cy2016-1/dummy/bom/README.md

# Belts caculation tools
1. https://jp.misumi-ec.com/tbtp/FA_WEB/pulley_cn/?rid=article
1. http://gaigibelt.com/competitionDetail/id/424.html
