cy2016-1/dummy/bom/all_parts_dummy_1210.xlsx

Sheet: Motor-42
Comment | Description | Designator | Footprint | LibRef | Quantity
0.1uF | Capacitor | C1, C2, C4, C5, C6, C7, C8, C9, C15, C17, C18, C21, C25, C26 | CAP_0402 | 电容-0402 | 14
10uF | Capacitor | C3, C10, C19, C22, C24 | CAP_0402 | 电容-0402 | 5
100uF | Capacitor | C11, C12, C13, C14 | 1206-CAP | 电容-1206 | 4
100pF | Capacitor | C16 | CAP_0402 | 电容-0402 | 1
10uF/50V | Capacitor | C20 | CAP_0402 | 电容-0402 | 1
10nF | Capacitor | C23 | CAP_0402 | 电容-0402 | 1
SS54 | Diode | D1 | DO-214AC | Diode_SMA | 1
SMBJ28CA |  | D2 | SMBJ-CA_MFG | SMBJ28CA | 1
二极管-5819W | 40V | D3, D4 | SOD-323 | 二极管-5819W | 2
跳线 | Resistor | J1 | 0402-0R | 跳线 | 1
TACT 2P | Button | K1, K2 | ButtonTACT_3x4x2_180 | ButtonTACT_3x4x2_180 | 2
6.8uH |  | L1 | IND-201612 | 电感-201612 | 1
SH1.0-5P |  | P1 | SH1.0-5P | SH1.0-5P | 1
SH1.0-6P |  | P2, P3, P4 | SH1.0-6P | SH1.0-6P | 3
SH1.0-3P | Header | P5 | SH1.0-3P | SH1.0-3P | 1
1K | Resistor | R1, R2, R6, R7, R17 | RES_0402 | 电阻-0402 | 5
0.1R | Resistor | R3, R8 | 1206-RES | 电阻-1206 | 2
NCP15XH103F03RC | THERMISTOR 10K OHM NTC 0402 SMD | R4 | RES_0402 | NCP15XH103F03RC | 1
3.3K | Resistor | R5 | RES_0402 | 电阻-0402 | 1
10K | Resistor | R9, R10, R13, R16 | RES_0402 | 电阻-0402 | 4
120R | Resistor | R11, R12 | RES_0402 | 电阻-0402 | 2
1.8K | Resistor | R14 | RES_0402 | 电阻-0402 | 1
1M | Resistor | R15 | RES_0402 | 电阻-0402 | 1
测试点 |  | T1, T2 | TEST_PT | 测试点 | 2
TB67H450FNG | PWM Chopper Type DC Brushed Motor Driver | U1, U2 | SO-8-PAD | TB67H450FNG | 2
STM32F103CBT6 | ARM Cortex-M3 32-bit MCU, 128 KB Flash, 20 KB Internal RAM, 37 I/Os, 48-pin LQFP, -40 to 85 degC, Tray | U3 | LQFP-48 | STM32F103CBT6 | 1
TL431IDBZT | Adjustable precision shunt regulator 3-SOT-23 -40 to 85 | U4 | SOT23-3 | TL431IDBZT | 1 | taobao
SN65HVD232D |  | U5 | SO-8 | SN65HVD232D | 1
ME3116 | DC-DC | U6 | SOT23-6 | ME3116 | 1
LP2992 3V3 | LDO | U7 | SOT23-5 | LP2992 | 1
MT6816 | Magnetic Position Sensor | U8 | SO-8 | MT6816 | 1
12MHz | 村田贴片 | Y1 | 晶振-3P | 晶振-3Pin | 1 | taobao

Sheet: Motor-20
Comment | Description | Designator | Footprint | LibRef | Quantity
0.1uF | Capacitor | C1, C2, C3, C4, C5, C6, C7, C8, C11, C15, C16, C20, C21 | CAP_0402 | 电容-0402 | 13
100uF | Capacitor | C9, C10 | 1206-CAP | 电容-1206 | 2
10uF | Capacitor | C12, C17, C18, C19 | CAP_0402 | 电容-0402 | 4
10nF | Capacitor | C13 | CAP_0402 | 电容-0402 | 1
100pF | Capacitor | C14 | CAP_0402 | 电容-0402 | 1
SS54 | Diode | D1 | DO-214AC | Diode_SMA | 1
SMBJ28CA |  | D2 | SMBJ-CA_MFG | SMBJ28CA | 1
二极管-5819W | 40V | D3, D4 | SOD-323 | 二极管-5819W | 2
跳线 | Resistor | J1 | 0402-0R | 跳线 | 1
TACT 2P | Button | K1, K2 | ButtonTACT_3x4x2_180 | ButtonTACT_3x4x2_180 | 2
6.8uH |  | L1 | IND-201612 | 电感-201612 | 1
SH1.0-2P |  | P1, P2 | SH1.0-2P | SH1.0-2P | 2
SH1.0-3P | Header | P3 | SH1.0-3P | SH1.0-3P | 1
1K | Resistor | R1, R2, R4, R5, R14 | RES_0402 | 电阻-0402 | 5
0.1R | Resistor | R3, R6 | 1206-RES | 电阻-1206 | 2
10K | Resistor | R7, R8, R10, R13 | RES_0402 | 电阻-0402 | 4
120R | Resistor | R9 | RES_0402 | 电阻-0402 | 1
1.8K | Resistor | R11 | RES_0402 | 电阻-0402 | 1
1M | Resistor | R12 | RES_0402 | 电阻-0402 | 1
TB67H450FNG | PWM Chopper Type DC Brushed Motor Driver | U1, U2 | SO-8-PAD | TB67H450FNG | 2
STM32F103CBT6 | ARM Cortex-M3 32-bit MCU, 128 KB Flash, 20 KB Internal RAM, 37 I/Os, 48-pin LQFP, -40 to 85 degC, Tray | U3 | LQFP-48 | STM32F103CBT6 | 1
SN65HVD232D |  | U4 | SO-8 | SN65HVD232D | 1
LP2992 3V3 | LDO | U5 | SOT23-5 | LP2992 | 1
ME3116 | DC-DC | U6 | SOT23-6 | ME3116 | 1
MT6816 | Magnetic Position Sensor | U7 | SO-8 | MT6816 | 1
12MHz | 村田贴片 | Y1 | 晶振-3P | 晶振-3Pin | 1 | taobao

Sheet: REF-UNIT
Comment | Description | Designator | Footprint | LibRef | Quantity
OLED-12880 |  | 1 | OLED-12880 | OLED-12880 | 1
0.1uF | Capacitor | C1, C6, C7, C9, C12, C13, C14, C15, C16, C20 | CAP_0402 | 电容-0402 | 10
10uF | Capacitor | C2, C5, C10, C11, C17, C18, C19 | CAP_0402 | 电容-0402 | 7
10nF | Capacitor | C3, C4 | CAP_0402 | 电容-0402 | 2
2.2nF | Capacitor | C8 | CAP_0402 | 电容-0402 | 1
color? | LED | D1 | LED_0402_RED | LED_0402 | 1
B2B-Connector-28P-0.5mm |  | J1, J2 | B2B-0.5mm-28P-M | B2B-Connector-28P-0.5mm | 2
2K | Resistor | R1, R2, R3 | RES_0402 | 电阻-0402 | 3
4.7K | Resistor | R4, R5, R8 | RES_0402 | 电阻-0402 | 3
10K | Resistor | R6, R13 | RES_0402 | 电阻-0402 | 2
560K | Resistor | R7 | RES_0402 | 电阻-0402 | 1
120R/NC | Resistor | R9 | RES_0402 | 电阻-0402 | 1
0R | Resistor | R10, R11 | RES_0402 | 电阻-0402 | 2
22R | Resistor | R12, R14 | RES_0402 | 电阻-0402 | 2
LP2992 3V3 | LDO | U1 | SOT23-5 | LP2992 | 1
MPU6050 | 六轴传感器 | U2 | QFN-24 | MPU6050 | 1
SN65HVD232D |  | U3 | SO-8 | SN65HVD232D | 1
STM32F405RGT6 | ARM Cortex-M4 32-bit MCU+FPU, 210 DMIPS, 1024 kB Flash, 192 kB Internal RAM, 51 I/Os, 64-pin LQFP, -40 to 85 degC, Tray | U4 | LQFP-64_N | STM32F405RGT6 | 1
8MHz | 村田贴片 | Y1 | 晶振-3P | 晶振-3Pin | 1 | taobao

Sheet: REF-Base
Comment | Description | Designator | Footprint | LibRef | Quantity
RAINSUN |  | A1 | ANT-Rainsun-AN5120 | ANT-Rainsun-AP5120 | 1
10uF | Capacitor | C1, C5, C10, C15 | CAP_0402 | 电容-0402 | 4
0.1uF | Capacitor | C2, C4, C8, C9, C12, C14 | CAP_0402 | 电容-0402 | 6
1uF | Capacitor | C3 | CAP_0402 | 电容-0402 | 1
100uF | Capacitor | C6 | 1206-CAP | 电容-1206 | 1 | 22uF/35V
10nF | Capacitor | C7, C13 | CAP_0402 | 电容-0402 | 2
100pF | Capacitor | C11 | CAP_0402 | 电容-0402 | 1
10uF/50V | Capacitor | C16 | CAP_0402 | 电容-0402 | 1 | 2.2uF/35V
color? | LED | D1 | LED_0402_RED | LED_0402 | 1
SS54 | Diode | D2 | DO-214AC | Diode_SMA | 1
SMBJ28CA |  | D3 | SMBJ-CA_MFG | SMBJ28CA | 1
二极管-5819W | 40V | D4, D5 | SOD-323 | 二极管-5819W | 2
USB-TYPE-C-STAND |  | J1 | USB-TYPE-C-STAND | USB-TYPE-C-STAND | 1
6.8uH |  | L1 | IND-201612 | 电感-201612 | 1
SH1.0-5P |  | P1 | SH1.0-5P | SH1.0-5P | 1
SH1.0-2P |  | P2, P3, P4 | SH1.0-2P | SH1.0-2P | 3
SH1.0-3P | Header | P5, P6 | SH1.0-3P | SH1.0-3P | 2
BC847BVC-7 |  | Q1 | SOT563-6 | BC847BVC-7 | 1
AO3400A | N-MOS | Q2 | SOT23-3 | AO3400A | 1
AO3401A | P-MOS | Q3 | SOT23-3 | AO3401A | 1
10K | Resistor | R1, R5, R10, R11, R15 | RES_0402 | 电阻-0402 | 5
0R | Resistor | R2 | RES_0402 | 电阻-0402 | 1
200R | Resistor | R3 | RES_0402 | 电阻-0402 | 1
12K | Resistor | R4, R6 | RES_0402 | 电阻-0402 | 2
2K | Resistor | R7, R12 | RES_0402 | 电阻-0402 | 2
5.1K | Resistor | R8, R9 | RES_0402 | 电阻-0402 | 2
1K | Resistor | R13 | RES_0402 | 电阻-0402 | 1
1.8K | Resistor | R14 | RES_0402 | 电阻-0402 | 1
1M | Resistor | R16 | RES_0402 | 电阻-0402 | 1
REF-Unit | Robot Embedded Framework based on STM43F405RGT6. | S1 | REF-UNIT | REF-Unit | 1
CP2102 | USB转TTL | U1 | QFN-28 | CP2102 | 1
ESP32_SIP |  | U2 | QFN-48_7X7 | ESP32-PICO | 1
LP2992 3V3 | LDO | U3, U6 | SOT23-5 | LP2992 | 2
DET402 |  | U4 | DET402 | DET402 | 1
SN65HVD232D |  | U5 | SO-8 | SN65HVD232D | 1
NRF24L01 |  | U7 | NRF24L01-MODULE | NRF24L01模块 | 1
ME3116 | DC-DC | U8 | SOT23-6 | ME3116 | 1
S8050 | Surface mount NPN transistor, package SOT-23 | VT1 | SMT_TRIODE_NPN | SMT_TRIODE_NPN | 1

Sheet: screws
 |  | 数量
J1
M4*21mm |  | 2
M4*12MM | mini11 减速器到base外壳 | 2
M3*34MM | 42电机 | 4
M3*5MM | mini11 减速器适配件固定到42电机 | 2
M3*20MM | j1 固定到外壳 | 6
M3*18MM | j1 连杆固定到j2减速器 | 3
固定底座
M3*28MM | 固定到底座 | 4
J2/J3
M3*25 | 固定j2/j3减速器适配件 | 4
M3*30 | 固定j2/j3减速器到连杆 | 4
M3*15 | 固定j2 42 Motor到连杆 | 4
M3*42 | 固定3个 42 Motor 驱动板 | 12
M3*11MM | 固定j3 42 Motor到连杆 | 4
Joint4
M3*6MM | 固定j4 35 Motor到连杆 | 4
M3*13MM | 固定3个 35 Motor 驱动板 | 12
M3*13Mm | 固定j4减速器到连杆 | 3
Joint5
M3*8MM | 固定2个 35 Motor 到连杆 | 4
M3*19MM | 固定j5减速器到连杆 | 1

Sheet: 3d
 |  | 数量
Base.stl | joint1底座 | 1
joint23.stl | joint23联杆 | 1
joint4.stl | joint4联杆 | 1
joint5.stl | joint5联杆 | 1
joint6.stl | joint6联杆 | 1
mini11-bracket-metal.stl | mini11与42电机连接支架 | 1
mini8-bracket-metal.stl | mini8谐波连接支架 | 4
motor42-bracket-top-metal.stl | 42驱动板散热顶盖 | 3
motor35-bracket-top-metal.stl | 35驱动板散热顶盖 | 2

Sheet: parts
42电机驱动板 |  | 3 | b站 木子晓汶 工房
35电机驱动板 |  | 3 | b站 木子晓汶 工房
42 电机 | l=40 1a | 3 | https://item.taobao.com/item.htm?id=549501040122&ns=1&abbucket=13
35 电机 | l=28 1a | 3 | https://item.taobao.com/item.htm?spm=a1z09.2.0.0.17872e8dTWSTmP&id=15168111895&_u=83jnrl7aaaff
减速器 | mini11 | 1 | taobao
减速器 | mini8 | 5 | taobao
同步轮 | 20齿内孔5mm外径18 | 8 | https://item.taobao.com/item.htm?spm=a1z09.2.0.0.19b12e8dfRIPU3&id=625483500699&_u=a3jnrl7adc93
同步皮带 | 152mm | 1 | https://item.taobao.com/item.htm?spm=a1z09.2.0.0.19b12e8dfRIPU3&id=626759355655&_u=a3jnrl7aa476
同步皮带 | 120mm | 1 | https://item.taobao.com/item.htm?spm=a1z09.2.0.0.19b12e8dfRIPU3&id=626759355655&_u=a3jnrl7aa476
同步皮带 | 110mm | 1 | https://item.taobao.com/item.htm?spm=a1z09.2.0.0.19b12e8dfRIPU3&id=626759355655&_u=a3jnrl7aa476
同步皮带 | 184mm | 1 | https://item.taobao.com/item.htm?spm=a1z09.2.0.0.19b12e8dfRIPU3&id=626759355655&_u=a3jnrl7aa476
电源开关 | 开孔直径：16mm，12-24v | 1 | https://item.taobao.com/item.htm?spm=a1z09.2.0.0.6dcd2e8dgKFAl1&id=589544046782&_u=93jnrl7aceb2
DC电源插座 | DC5.5*2.5mm | 1 | https://item.taobao.com/item.htm?spm=a1z09.2.0.0.6dcd2e8dgKFAl1&id=679108658727&_u=93jnrl7a3b6f
电源 | 24v 6a | 1 | https://item.taobao.com/item.htm?spm=a1z09.2.0.0.6dcd2e8dgKFAl1&id=552809889509&_u=93jnrl7a25cd
6pin排线 | zh1.5mm 30CM(定做) | 1 | https://detail.tmall.com/item.htm?_u=93jnrl7a54c7&id=642559605753&spm=a1z09.2.0.0.6dcd2e8dgKFAl1
6pin排线 | zh1.5mm 20CM(定做) | 6 | https://detail.tmall.com/item.htm?_u=93jnrl7a54c7&id=642559605753&spm=a1z09.2.0.0.6dcd2e8dgKFAl1
