cy2016-1/dummy/3d-model/OutStpFan/dummy_boards_bom.xlsx

Sheet: REF
Comment | Quantity | Designator | Footprint | Layer
0R | 4 | R2, R26, R27, R29 | RES_0402_1 | Top
0.1uF | 9 | C2, C8, C12, C14, C18, C19, C21, C22, C37 | CAP_0402 | Top
1K | 1 | R13 | RES_0402_1 | Top
1M | 1 | R16 | RES_0402_1 | Top
1uF | 1 | C3 | CAP_0402 | Top
1.8K | 1 | R14 | RES_0402_1 | Top
2K | 2 | R12, R18 | RES_0402_1 | Top
4.7K | 3 | R19, R20, R23 | RES_0402_1 | Top
4.7uF | 1 | C16 | C0603 | Top
5.1K | 2 | R8, R9 | RES_0402_1 | Top
6.8uH | 1 | L1 | IND-201612 | Top
10K | 6 | R1, R5, R10, R11, R15, R21 | RES_0402_1 | Top
10uF | 4 | C1, C15, C26, C27 | CAP_0402 | Top
12K | 2 | R4, R6 | RES_0402_1 | Top
100pF | 1 | C11 | CAP_0402 | Top
200R | 1 | R3 | RES_0402_1 | Top
560K | 1 | R22 | RES_0402_1 | Top
AO3400A | 1 | Q2 | SOT23-3 | Top
AO3401A | 1 | Q3 | SOT23-3 | Top
BC847BVC-7 | 1 | Q1 | SOT563-6 | Top
CP2102 | 1 | U1 | QFN-28 | Top
ESP32_SIP | 1 | U2 | QFN-48_7X7 | Top
Header 6H | 1 | P2 | CONN-TH_HC-ZH1.5-6A-s | Top
LED GREEN | 1 | LED1 | LED-0603 | Top
ME3116 | 1 | U8 | SOT23-6 | Top
MLT-7525 | 1 | U4 | BUZ-SMD_4P-L7.5-W7.5-P7.59-TL | Top
NRF24L01 | 1 | U7 | NRF24L01-MODULE | Top
OLED-12880 | 1 | 1 | OLED-12880 | Top
RAINSUN | 1 | A1 | ANT-Rainsun-AN5120 | Top
S8050 | 1 | VT1 | SMT_TRIODE_NPN | Top
SMBJ28CA | 1 | D3 | SMBJ-CA_MFG | Top
SN65HVD232D | 1 | U11 | SO-8 | Top
SS54 | 1 | D2 | DO-214AC | Top
USB-TYPE-C-STAND | 1 | J1 | USB-TYPE-C-STAND | Top
b5819W | 2 | D4, D5 | SOD-323 | Top
0R | 2 | R25, R31 | RES_0402_1 | Bottom
0.1uF | 10 | C4, C20, C23, C25, C28, C29, C30, C31, C32, C36 | CAP_0402 | Bottom
1M | 1 | R30 | RES_0402 | Bottom
2K | 2 | R7, R17 | RES_0402_1 | Bottom
2.2nF | 1 | C24 | CAP_0402 | Bottom
2.2uH | 1 | L2 | IND-252012A-2R2 | Bottom
10K | 2 | R28, R34 | RES_0402_1 | Bottom
10uF | 3 | C33, C34, C35 | CAP_0402 | Bottom
20pF | 2 | C7, C9 | CAP_0402 | Bottom
20pF | 1 | C13 | CAP_0402 | Bottom
22uF | 3 | C5, C10, C17 | C0603 | Bottom
22.1K | 1 | R35 | RES_0402_1 | Bottom
100K | 1 | R33 | RES_0402_1 | Bottom
120R/NC | 1 | R24 | RES_0402_1 | Bottom
220uF/25V | 1 | C6 | CAP-SMD_BD8.0-L8.3-W8.3-LS9.3-FD | Bottom
Header 3 | 1 | P3 | CONN-TH_HC-ZH1.5-3A-S | Bottom
Header 6H | 1 | P1 | CONN-TH_HC-ZH1.5-6A | Bottom
MPU6050 | 1 | U10 | QFN-24 | Bottom
STM32F405RGT6 | 1 | U12 | LQFP-64_N | Bottom
SY8089 2A | 1 | U3 | SOT23-5 | Bottom
XTAL-4 | 1 | Y1 | LC-SMD-3225_4P | Bottom

Sheet: Motor-42
Comment | Description | Designator | Footprint | Quantity | Layer
0.1R | Resistor | R3, R8 | 1206-RES | 2 | Bottom
10uF/50V | Capacitor, chip, ceramic | C29, C30, C31, C32, C33, C34 | 1206-CAP | 6 | Bottom
MT6816 | Magnetic Position Sensor | U8 | SO-8 | 1 | Bottom
SN65HVD232D |  | U5 | so-8 | 1 | Bottom
0 | Resistor | R21, R22 | RES_0402 | 2 | Top
0R | Resistor | R20 | 1206-RES | 1 | Top
0.1uF | Capacitor | C1, C2, C4, C5, C6, C7, C8, C9, C15, C17, C18, C21, C23, C25, C26, C27, C28, C35, C36 | CAP_0402 | 19 | Top
1K | Resistor | R1, R2, R6, R7, R11, R17, R18 | RES_0402 | 7 | Top
1M | Resistor | R15, R19 | RES_0402 | 2 | Top
1.8K | Resistor | R14 | RES_0402 | 1 | Top
3.3K | Resistor | R5 | RES_0402 | 1 | Top
6.8uH |  | L1 | IND-201612 | 1 | Top
10K | Resistor | R9, R10, R13, R16 | RES_0402 | 4 | Top
10uF | Capacitor | C3, C10, C19, C22, C24 | CAP_0402 | 5 | Top
10uF/50V | Capacitor | C20 | 1206-CAP | 1 | Top
20pF | Capacitor | C12, C13 | CAP_0402 | 2 | Top
100pF | Capacitor | C16 | CAP_0402 | 1 | Top
120R | Resistor | R12 | RES_0402 | 1 | Top
220uF/25V | Capacitor, chip, ceramic | C11, C14 | CAP-SMD_BD8.0-L8.3-W8.3-LS9.3-FD | 2 | Top
DSHP04TSGER | DIP Switches / SIP Switches 4 pos. low profile Btm Seal Tape J Bend | S1 | SW-SMD_DSHP04TS-S | 1 | Top
Header 6H | Header, 6-Pin, Right Angle | P1, P2, P3 | CONN-TH_HC-ZH1.5-6A-s | 3 | Top
LED GREEN | LED GRN SGL RA 25mA 4.1V SMD | LED1, LED2 | LED-0603 | 2 | Top
LP2992 3V3 | LDO | U7 | SOT23-5 | 1 | Top
ME3116 | DC-DC | U6 | SOT23-6 | 1 | Top
NCP15XH103F03RC | THERMISTOR 10K OHM NTC 0402 SMD | R4 | RES_0402 | 1 | Top
SMBJ28CA |  | D2 | SMBJ-CA_MFG | 1 | Top
SS54 | Diode | D1 | DO-214AC | 1 | Top
STM32F103CBT6 | ARM Cortex-M3 32-bit MCU, 128 KB Flash, 20 KB Internal RAM, 37 I/Os, 48-pin LQFP, -40 to 85 degC, Tray | U3 | LQFP-48 | 1 | Top
TACT 2P | Button | K1, K2 | ButtonTACT_3x4x2_180 | 2 | Top
TB67H450FNG | PWM Chopper Type DC Brushed Motor Driver | U1, U2 | SO-8-PAD | 2 | Top
XTAL-4 | Crystal | Y1 | LC-SMD-3225_4P | 1 | Top
二极管-5819W | 40V | D3, D4 | SOD-323 | 2 | Top

Sheet: Motor-35
Comment | Quantity | Description | Designator | Footprint | Layer
0R | 1 | Resistor | R20 | 1206-RES | Bottom
0.1R | 2 | Resistor | R3, R8 | 1206-RES | Bottom
0.1uF | 2 | Capacitor | C21, C25 | CAP_0402 | Bottom
10uF | 2 | Capacitor | C22, C24 | CAP_0402 | Bottom
10uF/50V | 4 | Capacitor, chip, ceramic | C29, C30, C31, C32 | 1206-CAP | Bottom
LP2992 3V3 | 1 | LDO | U7 | SOT23-5 | Bottom
MT6816 | 1 | Magnetic Position Sensor | U8 | SO-8 | Bottom
SN65HVD232D | 1 |  | U5 | so-8 | Bottom
SS54 | 1 | Diode | D1 | DO-214AC | Bottom
0 | 2 | Resistor | R21, R22 | RES_0402 | Top
0.1uF | 15 | Capacitor | C1, C2, C4, C5, C6, C7, C8, C9, C15, C17, C18, C23, C27, C28, C36 | CAP_0402 | Top
1K | 6 | Resistor | R1, R2, R6, R7, R11, R18 | RES_0402 | Top
1M | 2 | Resistor | R15, R19 | RES_0402 | Top
1.8K | 1 | Resistor | R14 | RES_0402 | Top
3.3K | 1 | Resistor | R5 | RES_0402 | Top
6.8uH | 1 |  | L1 | IND-201612 | Top
10K | 3 | Resistor | R9, R10, R13 | RES_0402 | Top
10uF | 3 | Capacitor | C3, C10, C19 | CAP_0402 | Top
10uF/50V | 1 | Capacitor | C20 | 1206-CAP | Top
20pF | 2 | Capacitor | C12, C13 | CAP_0402 | Top
100pF | 1 | Capacitor | C16 | CAP_0402 | Top
120R | 1 | Resistor | R12 | RES_0402 | Top
220uF/25V | 1 | Capacitor, chip, ceramic | C11 | CAP-SMD_BD8.0-L8.3-W8.3-LS9.3-FD | Top
DSHP04TSGER | 1 | DIP Switches / SIP Switches 4 pos. low profile Btm Seal Tape J Bend | S1 | SW-SMD_DSHP04TS-S | Top
Header 6H | 3 | Header, 6-Pin, Right Angle | P1, P2, P3 | CONN-TH_HC-ZH1.5-6A-s | Top
LED GREEN | 2 | LED GRN SGL RA 25mA 4.1V SMD | LED1, LED2 | LED-0603 | Top
ME3116 | 1 | DC-DC | U6 | SOT23-6 | Top
NCP15XH103F03RC | 1 | THERMISTOR 10K OHM NTC 0402 SMD | R4 | RES_0402 | Top
SMBJ28CA | 1 |  | D2 | SMBJ-CA_MFG | Top
STM32F103CBT6 | 1 | ARM Cortex-M3 32-bit MCU, 128 KB Flash, 20 KB Internal RAM, 37 I/Os, 48-pin LQFP, -40 to 85 degC, Tray | U3 | LQFP-48 | Top
TACT 2P | 2 | Button | K1, K2 | ButtonTACT_3x4x2_180 | Top
TB67H450FNG | 2 | PWM Chopper Type DC Brushed Motor Driver | U1, U2 | SO-8-PAD | Top
XTAL-4 | 1 | Crystal | Y1 | LC-SMD-3225_4P | Top
二极管-5819W | 2 | 40V | D3, D4 | SOD-323 | Top

Sheet: Screws
J1/BASE
M2*10 | 2 | fixs to controller enclosure
M3*20 | 4 | fixs to ground board
M4*20 | 2 | base to MINI11 reducer
M4*12 | 2 | MINI11 reducer bracket
M3*5 | 3 | for REF board fixs to base, flat header
M3*5 | 2 | MINI11 reducer bracket
M3*20 | 6 | MINI11 reducer adaptor to 42 Motor body
M3*20 | 3 | Joint1 link fixs to reducer
J2/J3
M3*25 | 16 | for all 4 mini8 reducer
M3*30 | 4 | for mini8 reducer fixs to arm
M3*15 | 4 | for 42 motor fixs to arm
M3*45 | 12 | for all 42 motor fixs to drive board
M3*12 | 4 | for j2/j3 up 42 motor fixs to arm
J4
M3*6 | 4 | for 35 motor fixs to arm
M3*12 | 12 | for all 35 motor fixs to drive board
J5
M3*8MM | 4 | for 35 motor fixs to arm
M3*19MM | 4 | for mini8 reducer fixs to arm
MINI8 Cover
M3*5 | 12
Bearing
5*10*4 | 5 | inner*outer*tall

Sheet: belts
J2 | 152MM
J3 | 120mm

Sheet: 机加工列表
文件名 | 工件 | 数量
base_Dummy v164 v1 | 网格板 | 1
base1_Dummy v164 v1 | 底座 | 1
base2_Dummy v164 v1 | 底座固定垫片 | 1
Joint1_Dummy v164 v1 | j1 | 1
Joint2_Joint3_Dummy v164 v1 | j2_3 | 1
Joint4_Dummy v164 v1 | j4 | 1
Joint5_Dummy v164 v1 | j5 | 1
Joint6_Dummy v164 v3 | j6 | 1
min-11-bra-connection v164 v1 | 11-30减速器支架 | 1
mini8-cover1105 v164 v1 | 8-50减速器支架 | 4
motor35-br-top v164 v1 | 35电机散热盖 | 3
motor42-br-top v164 v1 | 42电机散热盖 | 3
