cy2016-1/dummy/3d-model/OutStpFan/3D/controller_enclosure.stl

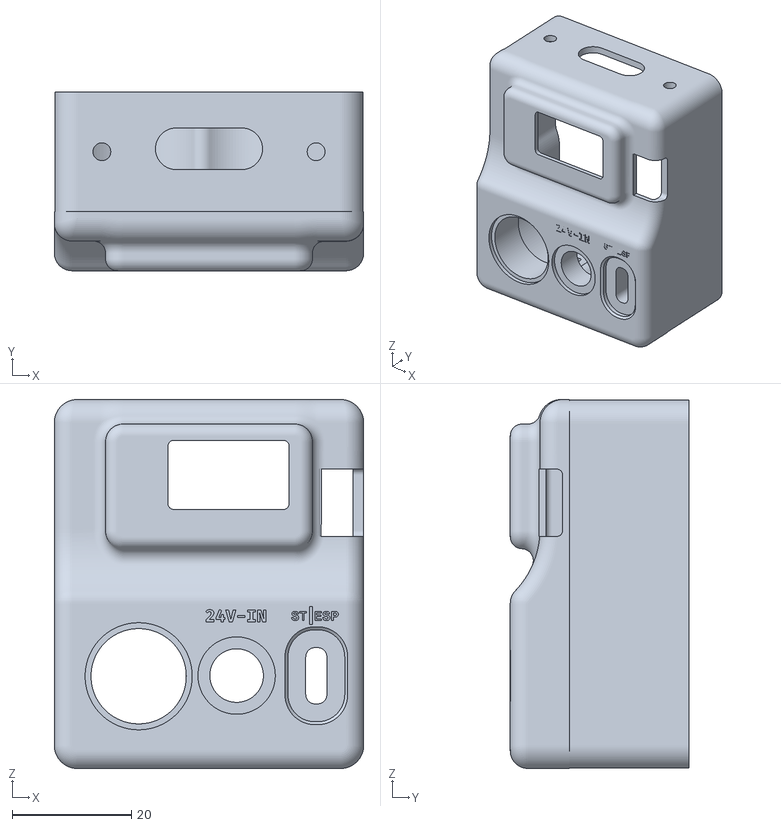
[picture p1: CAD file, 2023-12-11]
3d-model/OutStpFan/3D/controller_enclosure.stl
52.0 x 30.0 x 62.0
