cy2016-1/dummy/3d-model/OutStpFan/3D/m35/motor35-bracket-bot.stl

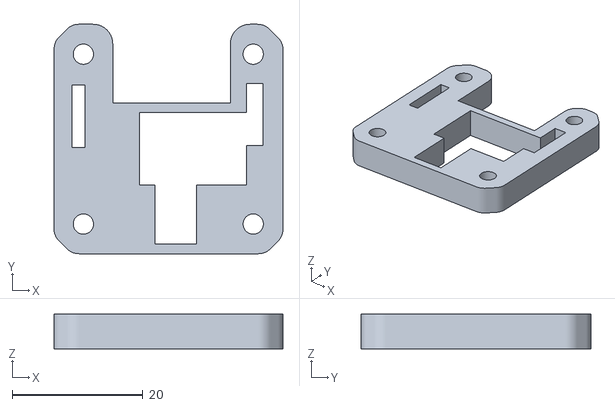
[picture p2: CAD file, 2023-12-11]
3d-model/OutStpFan/3D/m35/motor35-bracket-bot.stl
35.1 x 35.1 x 5.30
