cy2016-1/dummy/3d-model/OutStpFan/3D/m42/motor42-bracket-top-metal.stl

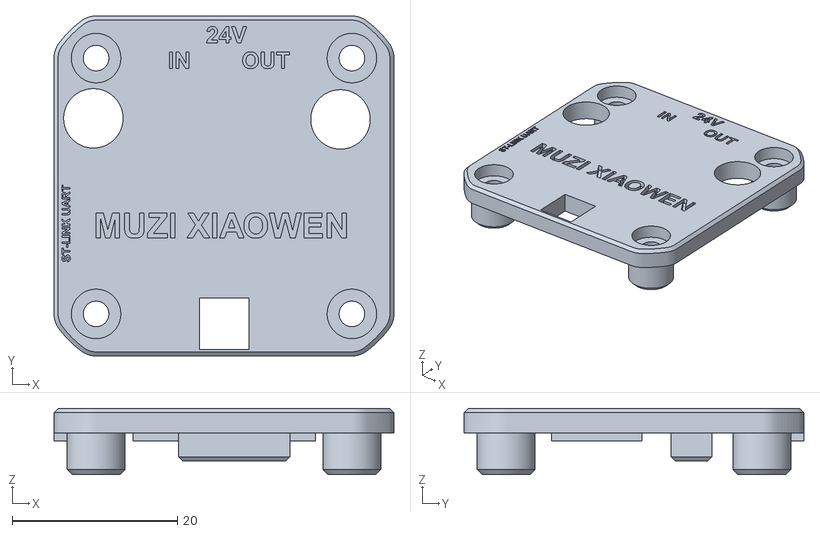
[picture p3: CAD file, 2023-12-11]
3d-model/OutStpFan/3D/m42/motor42-bracket-top-metal.stl
41.2 x 41.2 x 8.00
