cy2016-1/dummy/3d-model/OutStpFan/CNC/min-11-bra-connection v164 v1.STEP

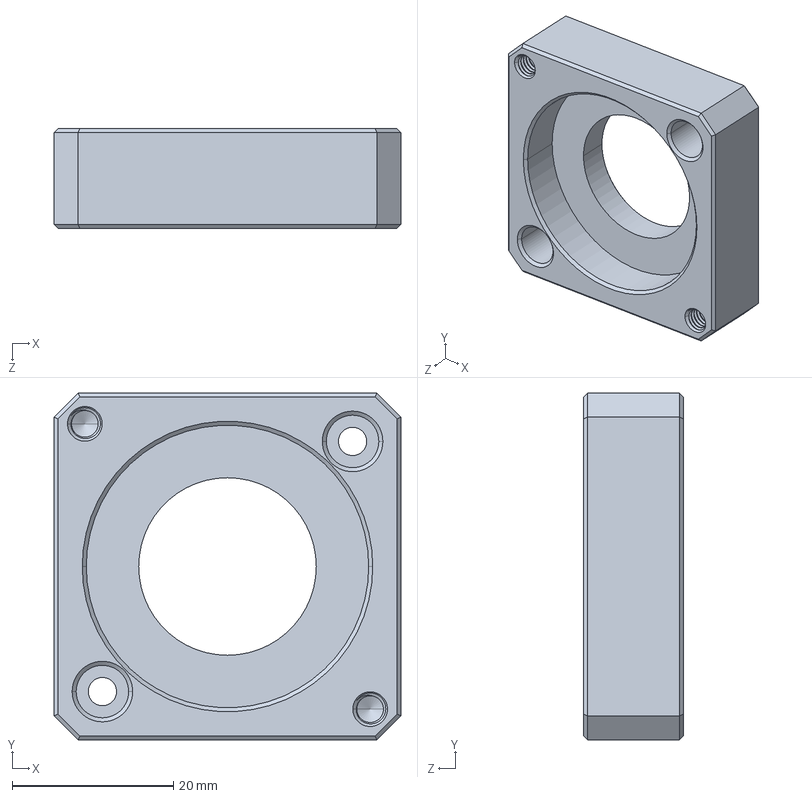
[picture p4: CAD file, 2023-12-11]
3d-model/OutStpFan/CNC/min-11-bra-connection v164 v1.STEP
43.0 x 43.0 x 12.4 mm
