cy2016-1/dummy/3d-model/OutStpFan/src/Joint5_Dummy v164 v1.SLDPRT

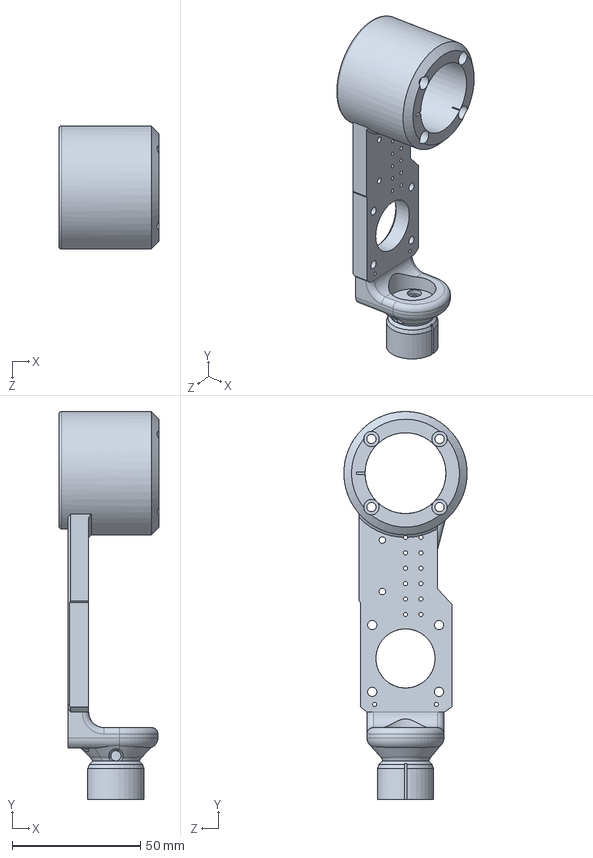
[picture p6: CAD file, 2023-12-11]
3d-model/OutStpFan/src/Joint5_Dummy v164 v1.SLDPRT
39.0 x 151.0 x 48.0 mm
