cy2016-1/dummy/3d-model/OutStpFan/3D/3DJoint5_Dummy v164 v2.STEP

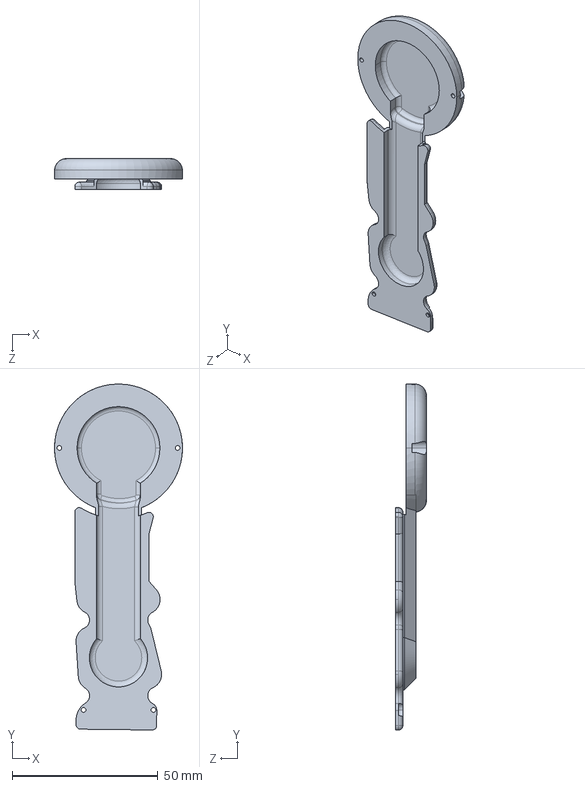
[picture p7: CAD file, 2023-12-11]
3d-model/OutStpFan/3D/3DJoint5_Dummy v164 v2.STEP
44.0 x 118.9 x 10.6 mm
