cy2016-1/dummy/3d-model/OutStpFan/3D/m35/motor35-bracket-top-metal.stl

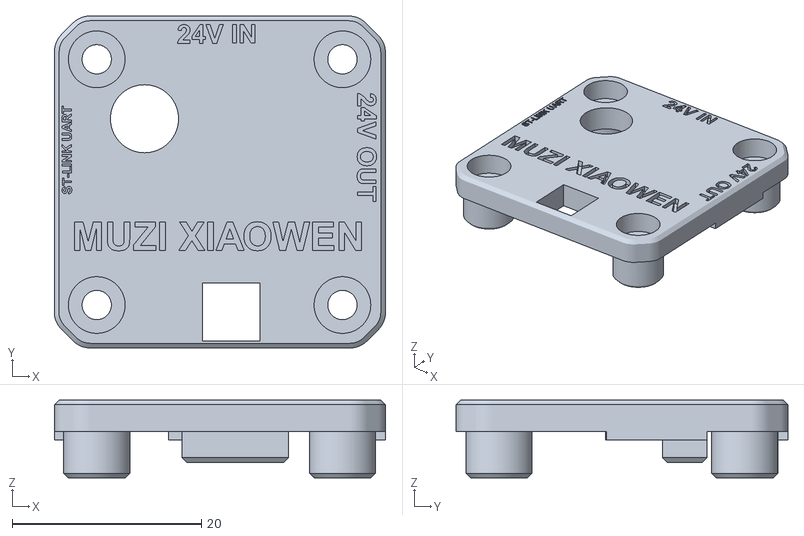
[picture p8: CAD file, 2023-12-11]
3d-model/OutStpFan/3D/m35/motor35-bracket-top-metal.stl
35.0 x 35.1 x 8.25
