cy2016-1/dummy/3d-model/OutStpFan/3D/m42/motor42-bracket-bot.stl

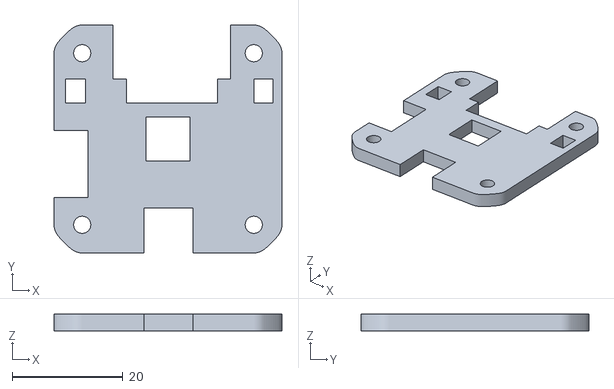
[picture p9: CAD file, 2023-12-11]
3d-model/OutStpFan/3D/m42/motor42-bracket-bot.stl
41.2 x 41.2 x 3.00
