cy2016-1/dummy/3d-model/OutStpFan/CNC/base_Dummy v164 v1.STEP

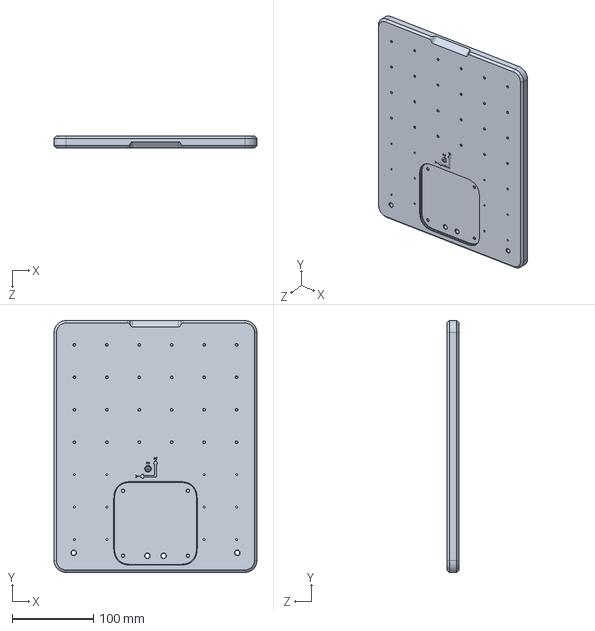
[picture p10: CAD file, 2023-12-11]
3d-model/OutStpFan/CNC/base_Dummy v164 v1.STEP
250.0 x 310.5 x 15.0 mm
