cy2016-1/dummy/3d-model/OutStpFan/src/Joint6_28Dummy v164 v4.SLDPRT

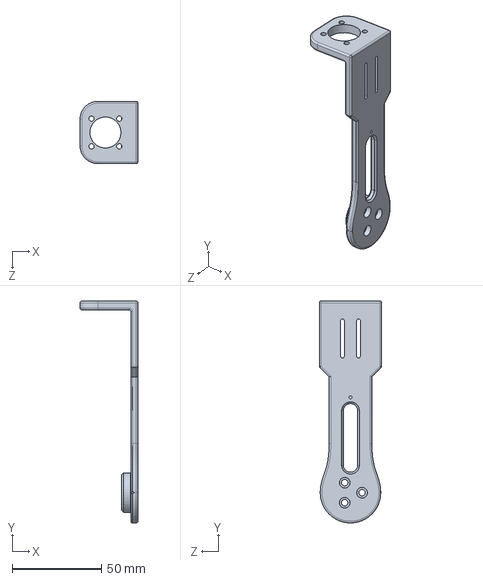
[picture p12: CAD file, 2023-12-11]
3d-model/OutStpFan/src/Joint6_28Dummy v164 v4.SLDPRT
32.5 x 124.6 x 35.0 mm
