cy2016-1/dummy/3d-model/OutStpFan/3D/3DJoint2 & Joint3_Dummy v164 v1.STEP

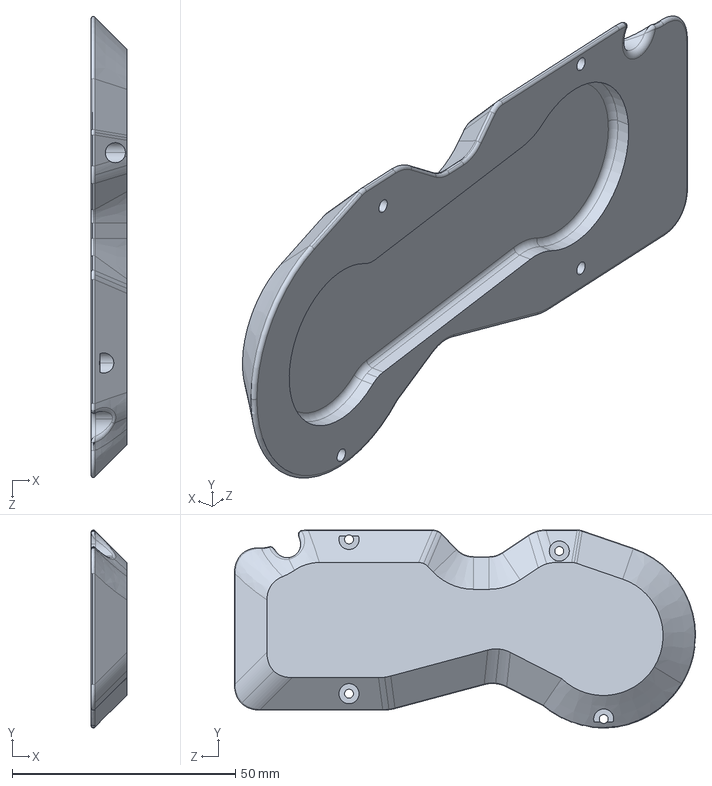
[picture p13: CAD file, 2023-12-11]
3d-model/OutStpFan/3D/3DJoint2 & Joint3_Dummy v164 v1.STEP
8.00 x 44.4 x 103.4 mm
