cy2016-1/dummy/3d-model/OutStpFan/src/Joint2 & Joint3_Dummy v164 v1.SLDPRT

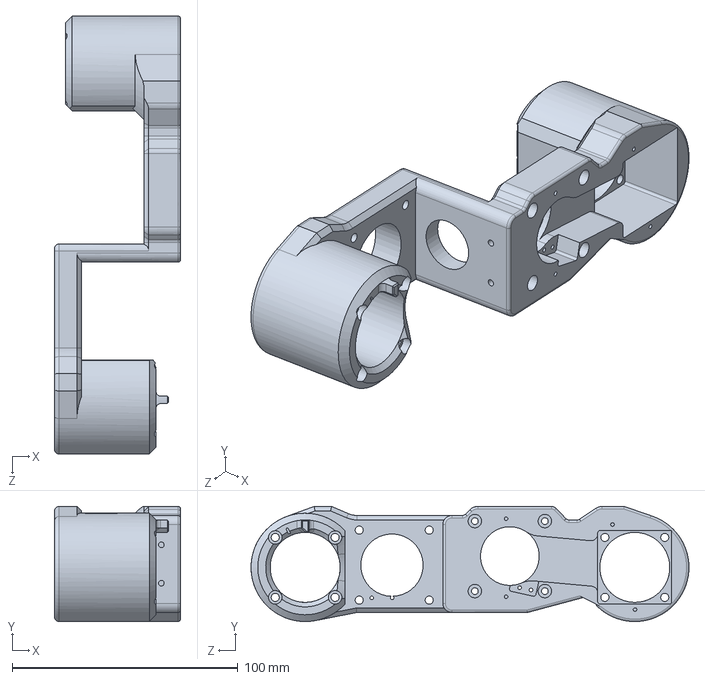
[picture p15: CAD file, 2023-12-11]
3d-model/OutStpFan/src/Joint2 & Joint3_Dummy v164 v1.SLDPRT
55.9 x 51.0 x 194.0 mm
