cy2016-1/dummy/3d-model/OutStpFan/3D/3D_1Joint2 & Joint3_Dummy v164 v1.STEP

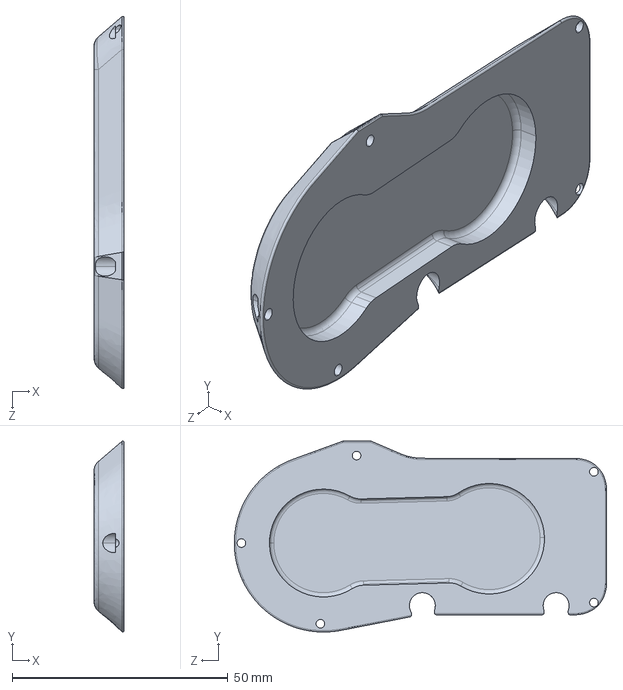
[picture p16: CAD file, 2023-12-11]
3d-model/OutStpFan/3D/3D_1Joint2 & Joint3_Dummy v164 v1.STEP
7.00 x 44.3 x 86.3 mm
