cy2016-1/dummy/3d-model/OutStpFan/CNC/base1_Dummy v164 v1.STEP

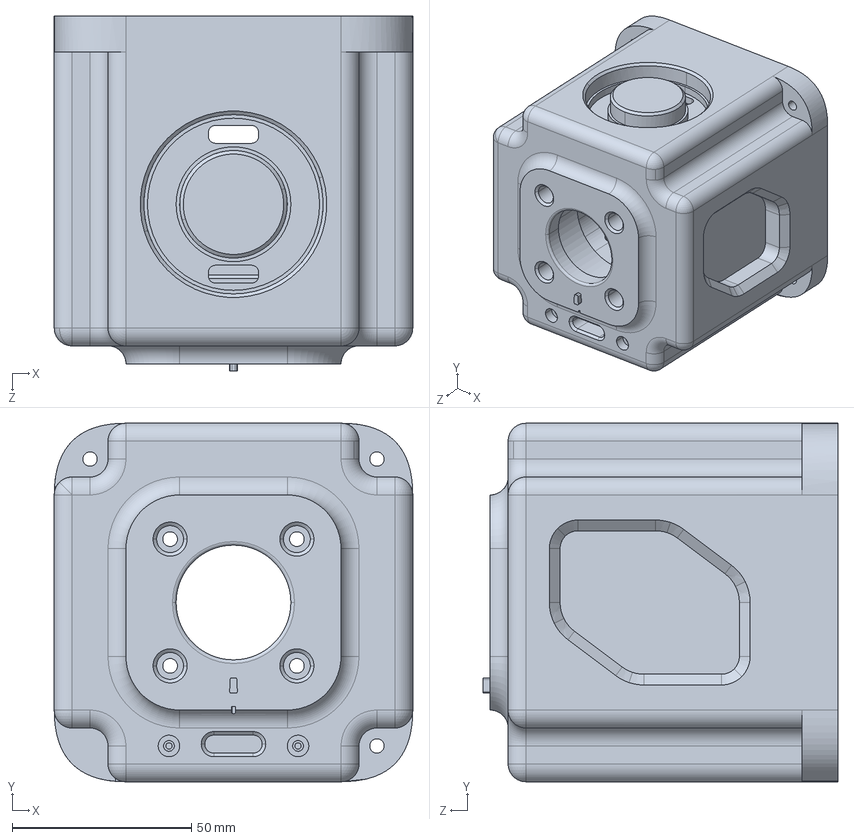
[picture p17: CAD file, 2023-12-11]
3d-model/OutStpFan/CNC/base1_Dummy v164 v1.STEP
100.0 x 100.0 x 99.0 mm
