cy2016-1/dummy/3d-model/OutStpFan/dxf/Joint4_Dummy v164 v1.DXF

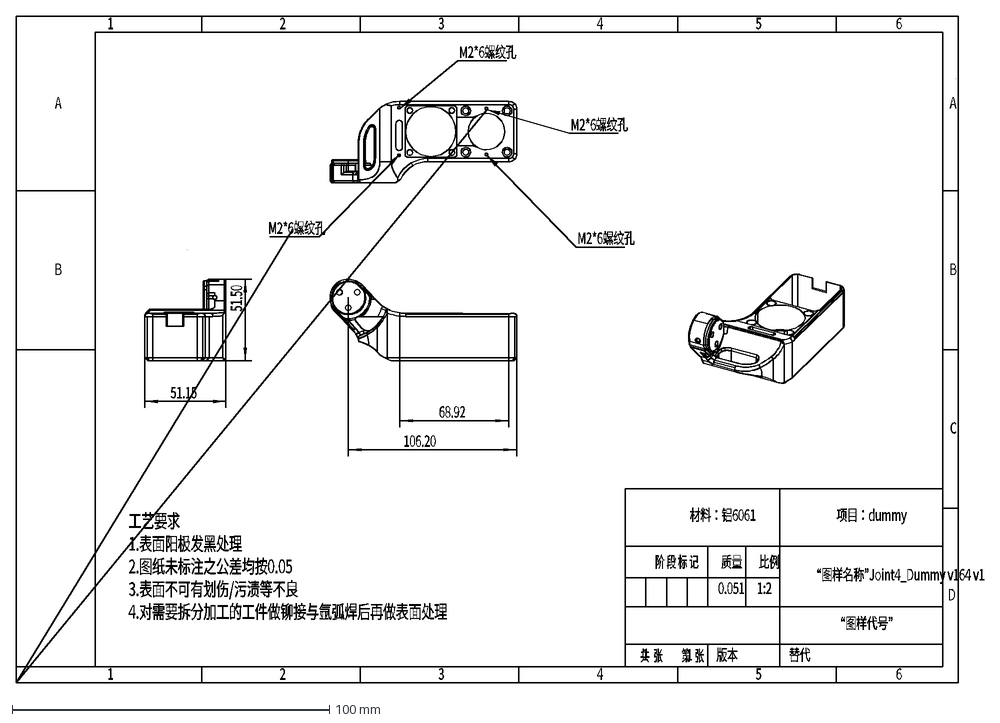
[picture p18: CAD file, 2023-12-11]
3d-model/OutStpFan/dxf/Joint4_Dummy v164 v1.DXF
替代
版本
比例
质量
第 张
共 张
阶 段 标 记
“图样代号”
“图样名称”Joint4_Dummy v164 v1
0.051
1
1:2
B
A
D
C
2
5
4
3
6
材料：铝6061
项目：dummy
工艺要求
1.表面阳极发黑处理
2.图纸未标注之公差均按0.05
3.表面不可有划伤/污渍等不良
4.对需要拆分加工的工件做铆接与氩弧焊后再做表面处理
68.92
106.20
M2*6螺纹孔
51.15
51.50
