cy2016-1/dummy/3d-model/OutStpFan/src/Joint1_Dummy v164 v1.SLDPRT

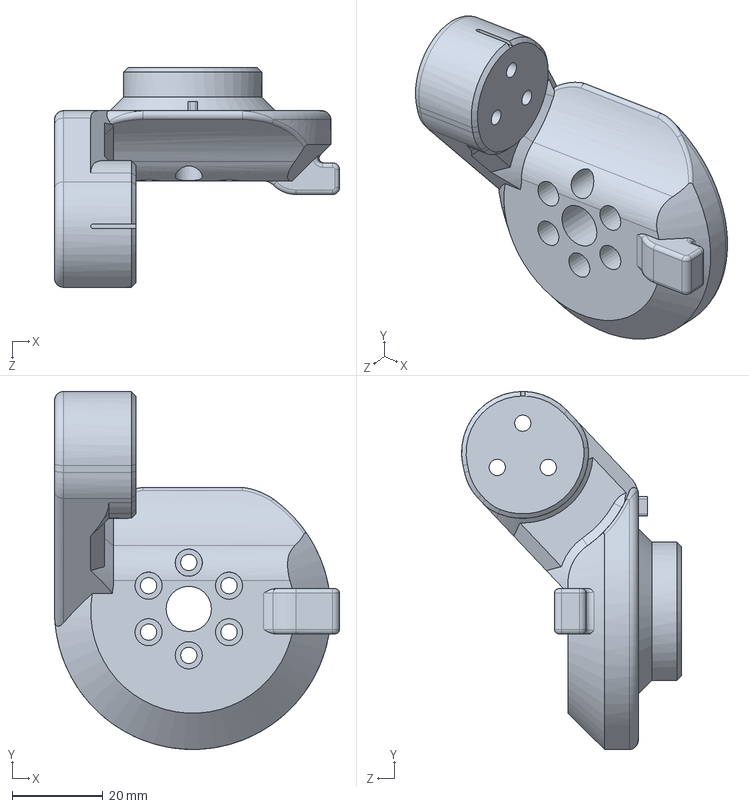
[picture p19: CAD file, 2023-12-11]
3d-model/OutStpFan/src/Joint1_Dummy v164 v1.SLDPRT
62.9 x 79.0 x 48.5 mm
