cy2016-1/dummy/3d-model/OutStpFan/3D/3DJoint4_Dummy v164 v2.STEP

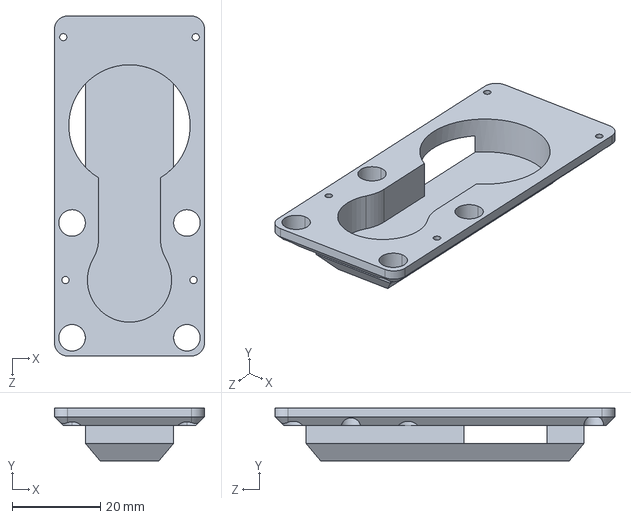
[picture p20: CAD file, 2023-12-11]
3d-model/OutStpFan/3D/3DJoint4_Dummy v164 v2.STEP
34.0 x 12.0 x 77.0 mm
