cy2016-1/dummy/3d-model/OutStpFan/CNC/Joint4_Dummy v164 v1.STEP

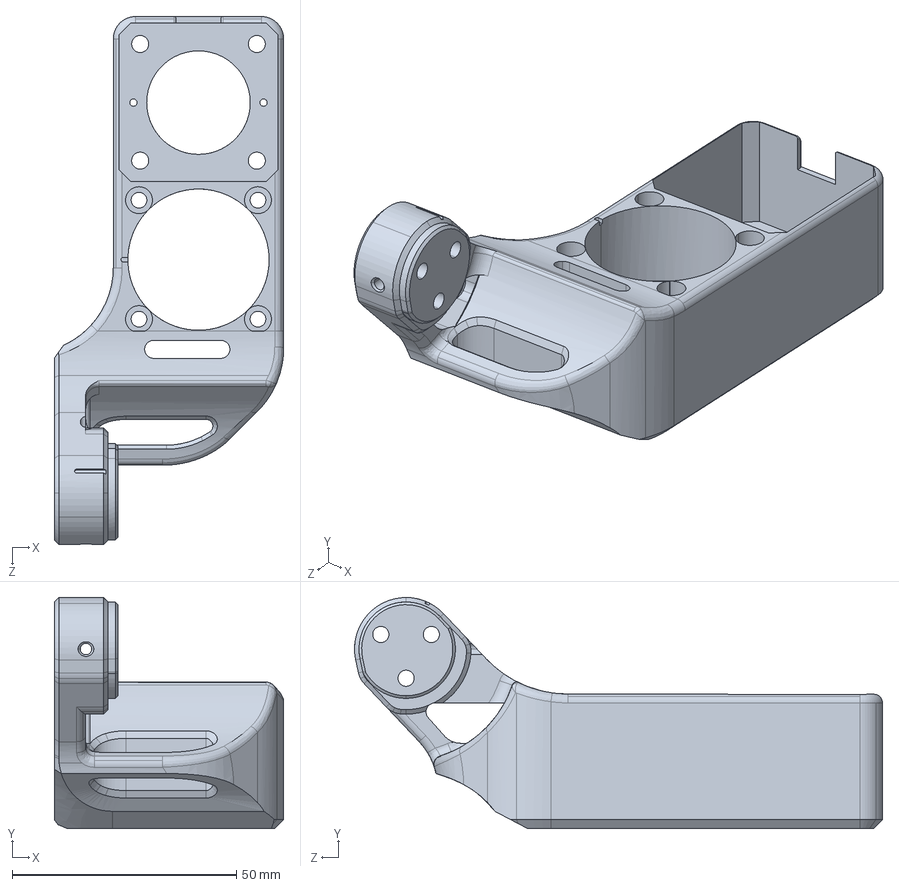
[picture p21: CAD file, 2023-12-11]
3d-model/OutStpFan/CNC/Joint4_Dummy v164 v1.STEP
51.2 x 51.5 x 117.7 mm
