cy2016-1/dummy/3d-model/OutStpFan/CNC/base2_Dummy v164 v1.STEP

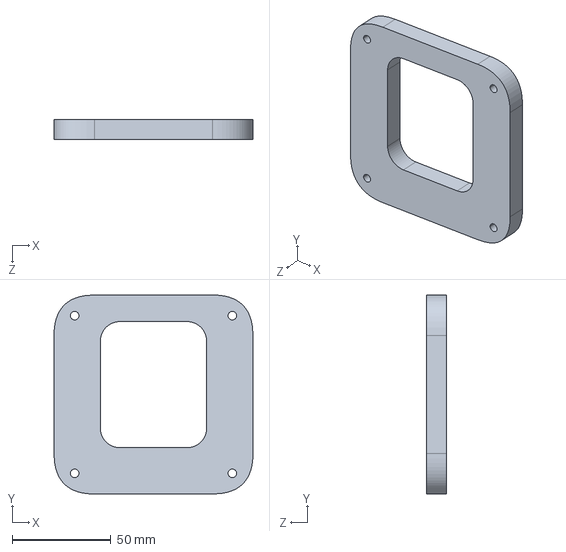
[picture p23: CAD file, 2023-12-11]
3d-model/OutStpFan/CNC/base2_Dummy v164 v1.STEP
101.0 x 101.0 x 10.0 mm
