cy2016-1/dummy/3d-model/OutStpFan/src/3dJoint4_Dummy v164 v1.SLDPRT

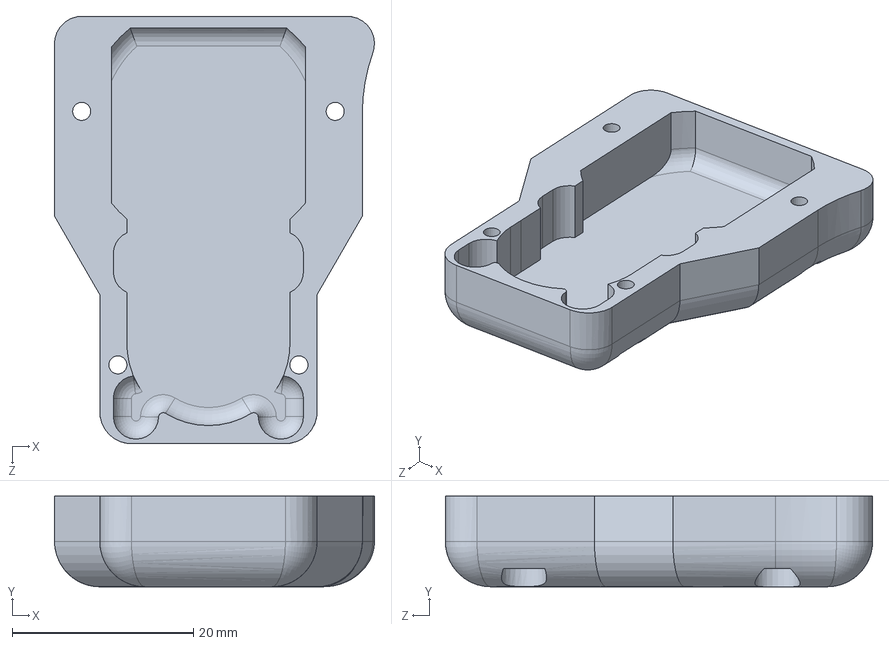
[picture p24: CAD file, 2023-12-11]
3d-model/OutStpFan/src/3dJoint4_Dummy v164 v1.SLDPRT
35.3 x 10.0 x 47.2 mm
