cy2016-1/dummy/3d-model/OutStpFan/CNC/mini8-cover1105 v164 v1.STEP

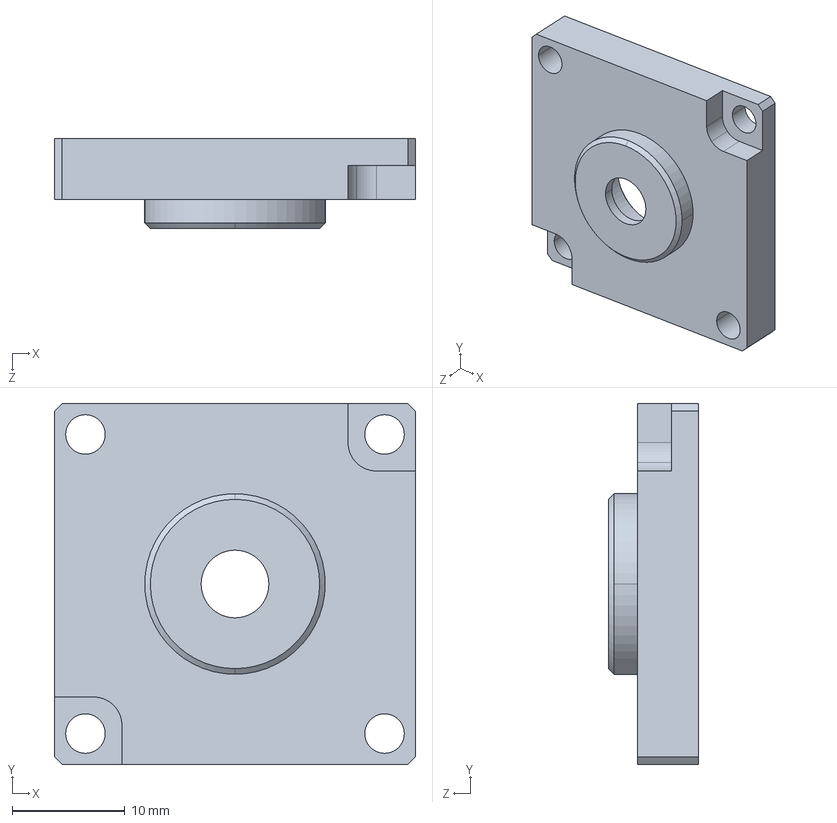
[picture p25: CAD file, 2023-12-11]
3d-model/OutStpFan/CNC/mini8-cover1105 v164 v1.STEP
32.0 x 32.0 x 8.00 mm
