cy2016-1/dummy/3d-model/OutStpFan/src/3DJoint4_Dummy v164 v3.SLDPRT

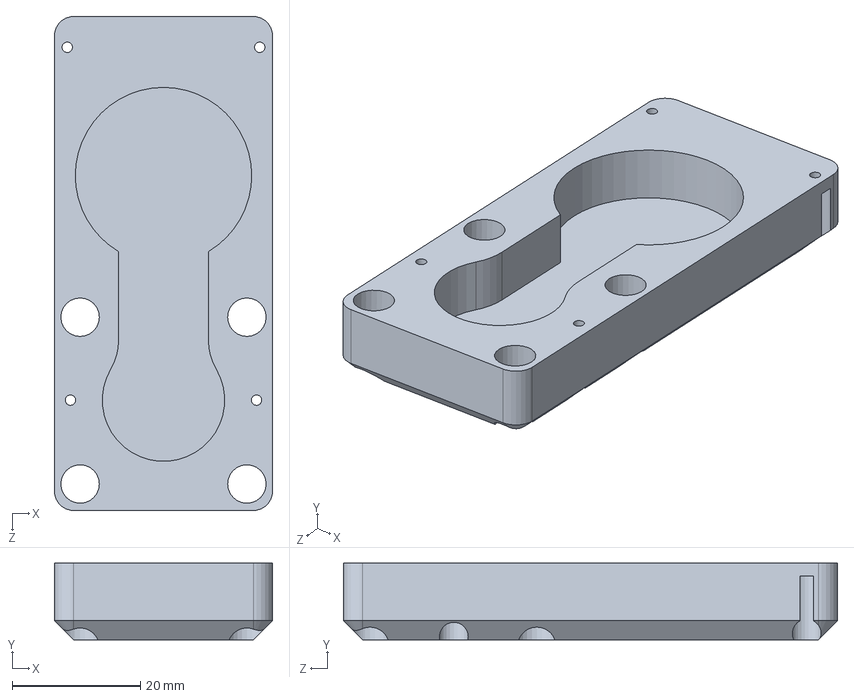
[picture p26: CAD file, 2023-12-11]
3d-model/OutStpFan/src/3DJoint4_Dummy v164 v3.SLDPRT
34.0 x 12.0 x 77.0 mm
