cy2016-1/dummy/(list of files, cad)

Other CAD files:
3d-model/OutStpFan/CNC/Joint5_Dummy v164 v1.STEP
3d-model/OutStpFan/src/3d_1Joint2 & Joint3_Dummy v164 v1.SLDPRT
3d-model/OutStpFan/CNC/Joint2_Joint3_Dummy v164 v1.STEP
3d-model/OutStpFan/src/Joint4_Dummy v164 v1.SLDPRT
3d-model/OutStpFan/CNC/Joint1_Dummy v164 v1.STEP
3d-model/OutStpFan/src/3DJoint4_Dummy v164 v2.SLDPRT
3d-model/OutStpFan/src/3dJoint2 & Joint3_Dummy v164 v1.SLDPRT
3d-model/OutStpFan/src/base2_Dummy v164 v1.SLDPRT
3d-model/OutStpFan/src/3DJoint5_Dummy v164 v3.SLDPRT
3d-model/OutStpFan/src/base_Dummy v164 v1.SLDPRT
3d-model/OutStpFan/src/base1_Dummy v164 v1.SLDPRT
3d-model/OutStpFan/Drawing/Joint1_Dummy v164 v1.SLDDRW
3d-model/OutStpFan/Drawing/Joint5_Dummy v164 v1.SLDDRW
3d-model/OutStpFan/Drawing/base1_Dummy v164 v1.SLDDRW
3d-model/OutStpFan/Drawing/base_Dummy v164 v1.SLDDRW
