cy2016-1/dummy/firmware/dummy-ref-core-fw/UserApp/protocols/ascii_protocol.cpp

#include "common_inc.h"

extern DummyRobot dummy;

void OnUsbAsciiCmd(const char* _cmd, size_t _len, StreamSink &_responseChannel)
{
    uint8_t  i;
    /*---------------------------- ↓ Add Your CMDs Here ↓ -----------------------------*/
    if (_cmd[0] == '!' )
    {
        std::string s(_cmd);
        if (s.find("STOP") != std::string::npos)
        {
            dummy.commandHandler.EmergencyStop();
            Respond(_responseChannel, "Stopped ok");
        } else if (s.find("START") != std::string::npos)
        {
            dummy.SetEnable(true);
            Respond(_responseChannel, "Started ok");
        } else if (s.find("HOME") != std::string::npos)
        {
            dummy.Homing();
            Respond(_responseChannel, "Started ok");
        } else if (s.find("CALIBRATION") != std::string::npos)
        {
            dummy.CalibrateHomeOffset();
            Respond(_responseChannel, "calibration ok");
        } else if (s.find("RESET") != std::string::npos)
        {
            dummy.Resting();
            Respond(_responseChannel, "Started ok");
        } else if (s.find("DISABLE") != std::string::npos)
        {
            dummy.SetEnable(false);
            Respond(_responseChannel, "Disabled ok");
        }
    } else if (_cmd[0] == '#')
    {
        std::string s(_cmd);
        if (s.find("GETJPOS") != std::string::npos)
        {
            Respond(_responseChannel, "ok %.2f %.2f %.2f %.2f %.2f %.2f",
                    dummy.currentJoints.a[0], dummy.currentJoints.a[1],
                    dummy.currentJoints.a[2], dummy.currentJoints.a[3],
                    dummy.currentJoints.a[4], dummy.currentJoints.a[5]);
        } else if (s.find("GETLPOS") != std::string::npos)
        {
            dummy.UpdateJointPose6D();
            Respond(_responseChannel, "ok %.2f %.2f %.2f %.2f %.2f %.2f",
                    dummy.currentPose6D.X, dummy.currentPose6D.Y,
                    dummy.currentPose6D.Z, dummy.currentPose6D.A,
                    dummy.currentPose6D.B, dummy.currentPose6D.C);
        } else if (s.find("SET_DCE_KP") != std::string::npos)
        {
            uint32_t kp;
            uint32_t node;
            sscanf(_cmd, "#SET_DCE_KP %lu %lu", &node, &kp);
            if (node >= 1 & node <= 6){
                dummy.motorJ[node]->SetDceKp(kp);
                Respond(_responseChannel, "ok SET MOTOR [%lu] DCE_KP [%lu]", node, kp);
            }
            else {
                Respond(_responseChannel, "error SET MOTOR [%lu] DCE_KP [%lu] is wrong", node, kp);
            }
        } else if (s.find("SET_DCE_KI") != std::string::npos)
        {
            uint32_t kp;
            uint32_t node;
            sscanf(_cmd, "#SET_DCE_KI %lu %lu", &node, &kp);
            if (node >= 1 & node <= 6){
                dummy.motorJ[node]->SetDceKi(kp);
                Respond(_responseChannel, "ok SET MOTOR [%lu] DCE_KI [%lu]", node, kp);
            }
            else {
                Respond(_responseChannel, "error SET MOTOR [%lu] DCE_KI [%lu] is wrong", node, kp);
            }
        } else if (s.find("SET_DCE_KD") != std::string::npos)
        {
            uint32_t kp;
            uint32_t node;
            sscanf(_cmd, "#SET_DCE_KD %lu %lu", &node, &kp);
            if (node >= 1 & node <= 6){
                dummy.motorJ[node]->SetDceKd(kp);
                Respond(_responseChannel, "ok SET MOTOR [%lu] DCE_KD [%lu]", node, kp);
            }
            else {
                Respond(_responseChannel, "error SET MOTOR [%lu] DCE_KD [%lu] is wrong", node, kp);
            }
        } else if (s.find("REBOOT") != std::string::npos)
        {
            uint32_t node;
            sscanf(_cmd, "#REBOOT %lu", &node);
            if (node >= 1 & node <= 6){
                dummy.motorJ[node]->Reboot();
                Respond(_responseChannel, "ok REBOOT MOTOR [%lu]", node);
            }
            else {
                Respond(_responseChannel, "error REBOOT MOTOR [%lu] is wrong", node);
            }
        }else if (s.find("CMDMODE") != std::string::npos)
        {
            uint32_t mode;
            sscanf(_cmd, "#CMDMODE %lu", &mode);
            dummy.SetCommandMode(mode);
            Respond(_responseChannel, "ok Set command mode to [%lu]", mode);
        } else
            Respond(_responseChannel, "ok");
    } else if (_cmd[0] == '>' || _cmd[0] == '@' || _cmd[0] == '&')
    {
        uint32_t freeSize = dummy.commandHandler.Push(_cmd);
        Respond(_responseChannel, "%d", freeSize);
    }

/*---------------------------- ↑ Add Your CMDs Here ↑ -----------------------------*/
}


void OnUart4AsciiCmd(const char* _cmd, size_t _len, StreamSink &_responseChannel)
{
    /*---------------------------- ↓ Add Your CMDs Here ↓ -----------------------------*/
    if (_cmd[0] == '!' || !dummy.IsEnabled())
    {
        std::string s(_cmd);
        if (s.find("STOP") != std::string::npos)
        {
            dummy.commandHandler.EmergencyStop();
            Respond(_responseChannel, "Stopped ok");
        } else if (s.find("START") != std::string::npos)
        {
            dummy.SetEnable(true);
            Respond(_responseChannel, "Started ok");
        } else if (s.find("HOME") != std::string::npos)
        {
            dummy.Homing();
            Respond(_responseChannel, "Started ok");
        } else if (s.find("CALIBRATION") != std::string::npos)
        {
            dummy.CalibrateHomeOffset();
            Respond(_responseChannel, "calibration ok");
        } else if (s.find("RESET") != std::string::npos)
        {
            dummy.Resting();
            Respond(_responseChannel, "Started ok");
        } else if (s.find("DISABLE") != std::string::npos)
        {
            dummy.SetEnable(false);
            Respond(_responseChannel, "Disabled ok");
        }
    } else if (_cmd[0] == '#')
    {
        std::string s(_cmd);
        if (s.find("GETJPOS") != std::string::npos)
        {
            Respond(_responseChannel, "ok %.2f %.2f %.2f %.2f %.2f %.2f",
                    dummy.currentJoints.a[0], dummy.currentJoints.a[1],
                    dummy.currentJoints.a[2], dummy.currentJoints.a[3],
                    dummy.currentJoints.a[4], dummy.currentJoints.a[5]);
        } else if (s.find("GETLPOS") != std::string::npos)
        {
            dummy.UpdateJointPose6D();
            Respond(_responseChannel, "ok %.2f %.2f %.2f %.2f %.2f %.2f",
                    dummy.currentPose6D.X, dummy.currentPose6D.Y,
                    dummy.currentPose6D.Z, dummy.currentPose6D.A,
                    dummy.currentPose6D.B, dummy.currentPose6D.C);
        } else if (s.find("CMDMODE") != std::string::npos)
        {
            uint32_t mode;
            sscanf(_cmd, "#CMDMODE %lu", &mode);
            dummy.SetCommandMode(mode);
            Respond(_responseChannel, "Set command mode to [%lu]", mode);
        } else
            Respond(_responseChannel, "ok");
    } else if (_cmd[0] == '>' || _cmd[0] == '@' || _cmd[0] == '&')
    {
        uint32_t freeSize = dummy.commandHandler.Push(_cmd);
        Respond(_responseChannel, "%d", freeSize);
    }
/*---------------------------- ↑ Add Your CMDs Here ↑ -----------------------------*/
}


void OnUart5AsciiCmd(const char* _cmd, size_t _len, StreamSink &_responseChannel)
{
    /*---------------------------- ↓ Add Your CMDs Here ↓ -----------------------------*/

/*---------------------------- ↑ Add Your CMDs Here ↑ -----------------------------*/
}
