cy2016-1/dummy/(commit log)

2023-12-10 modified: imu/MPU6050.cpp
    [daplink.cfg]
2023-12-10 add 35 file daplink.cfg
    [daplink.cfg]
2023-12-10 updata stp J6
    [28HS0405-28PG27J-300.SLDPRT, 3DJoint2 & Joint3_Dummy v164 v1.STEP, 3DJoint4_Dummy v164 v2.SLDPRT, 3DJoint4_Dummy v164 v2.STEP, 3DJoint4_Dummy v164 v3.SLDPRT, 3DJoint5_Dummy v164 v2.SLDPRT, 3DJoint5_Dummy v164 v2.STEP, 3DJoint5_Dummy v164 v3.SLDPRT]
2023-12-11 “fixj6arm28to35”
    [35HSH2408-36PG19J-300.SLDPRT, 35HSH2408-36PG19J-300.STEP, Joint5_Dummy v164 v1.SLDPRT, Joint6_28Dummy v164 v4.SLDPRT, Joint6_35Dummy v164 v3.SLDPRT, Joint6_Dummy v164 v1.STEP, Joint6_Dummy v164 v3.SLDPRT, Joint6_Dummy v164 v3.STEP]
2023-12-11 fix file
    [28HS0405-28PG27J-300.SLDPRT, 35HSH2408-36PG19J-300.SLDPRT, 35HSH2408-36PG19J-300.STEP, 3DJoint5_Dummy v164 v2.SLDPRT, 3dJoint6_Dummy v164 v1.SLDPRT, Joint2 & Joint3_Dummy v164 v1.DXF, Joint4_Dummy v164 v1.SLDDRW, Joint5_Dummy v164 v2.DXF]
2023-12-11 reset stp
    [3DJoint2 & Joint3_Dummy v164 v1.STEP, 3DJoint4_Dummy v164 v2.SLDPRT, 3DJoint4_Dummy v164 v2.STEP, 3DJoint4_Dummy v164 v3.SLDPRT, 3DJoint5_Dummy v164 v2.SLDPRT, 3DJoint5_Dummy v164 v2.STEP, 3DJoint5_Dummy v164 v3.SLDPRT, 3D_1Joint2 & Joint3_Dummy v164 v1.STEP]
2023-12-11 fix dxf
    [Joint2 & Joint3_Dummy v164 v1.SLDDRW, Joint2_Joint3_Dummy v164 v1.DXF]
2023-12-11 rm OUT
    [3DJoint2 & Joint3_Dummy v164 v1.STEP, 3DJoint4_Dummy v164 v2.SLDPRT, 3DJoint4_Dummy v164 v2.STEP, 3DJoint4_Dummy v164 v3.SLDPRT, 3DJoint5_Dummy v164 v2.SLDPRT, 3DJoint5_Dummy v164 v2.STEP, 3DJoint5_Dummy v164 v3.SLDPRT, 3D_1Joint2 & Joint3_Dummy v164 v1.STEP]
2023-12-12 fix chinese comment and add comment
    [ascii_protocol.cpp, communication.cpp, main.cpp, sca_api.c, sca_protocol.c]
2023-12-24 add file sw
    [serial_config.txt]
2024-01-22 add time10
    [stlink.cfg]
